filippabodecker/autonomous-dog-search-robot/(commit log)

2026-07-31 Add bill of materials
2026-08-03 Add ESP32 communication gateway
2026-08-27 Improve ESP32 code documentation
